camdeno/ECE-411-Team-5/breadboard prototype.jpg

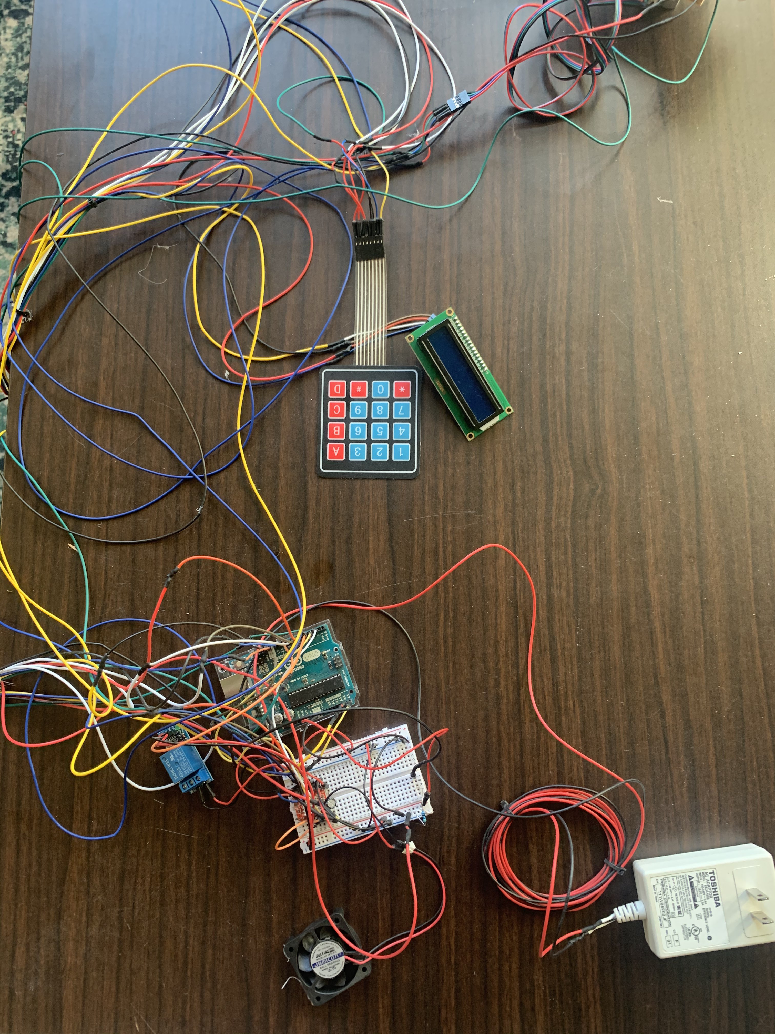
breadboard prototype.jpg
