camdeno/ECE-411-Team-5/README.md

# ECE-411-Team-5
This is our practicum project repository for ECE 411 Fall Term
