camdeno/ECE-411-Team-5/Schematics/Preliminary/readme.txt

- Add the 'Preliminary' folder under C:\...\Documents\EAGLE\projects
- Open EAGLE and you should be able to see 'Preliminary' under projects->projects

OR

- Open EAGLE and create a new project
- Import the 'Pre_sch.sch' file into your project
- Click on 'Generate / Switch board' to create a board layout
