camdeno/ECE-411-Team-5/Schematics/Final/readme.txt

This folder will contain the final schematic and board layout for the Door Lock project
