camdeno/ECE-411-Team-5/Door Lock UML.pdf

Door Lock
Team 05

Cam Osborn
Thomas Courcy
Daniel Sayenko
Abdullah Almarzouq

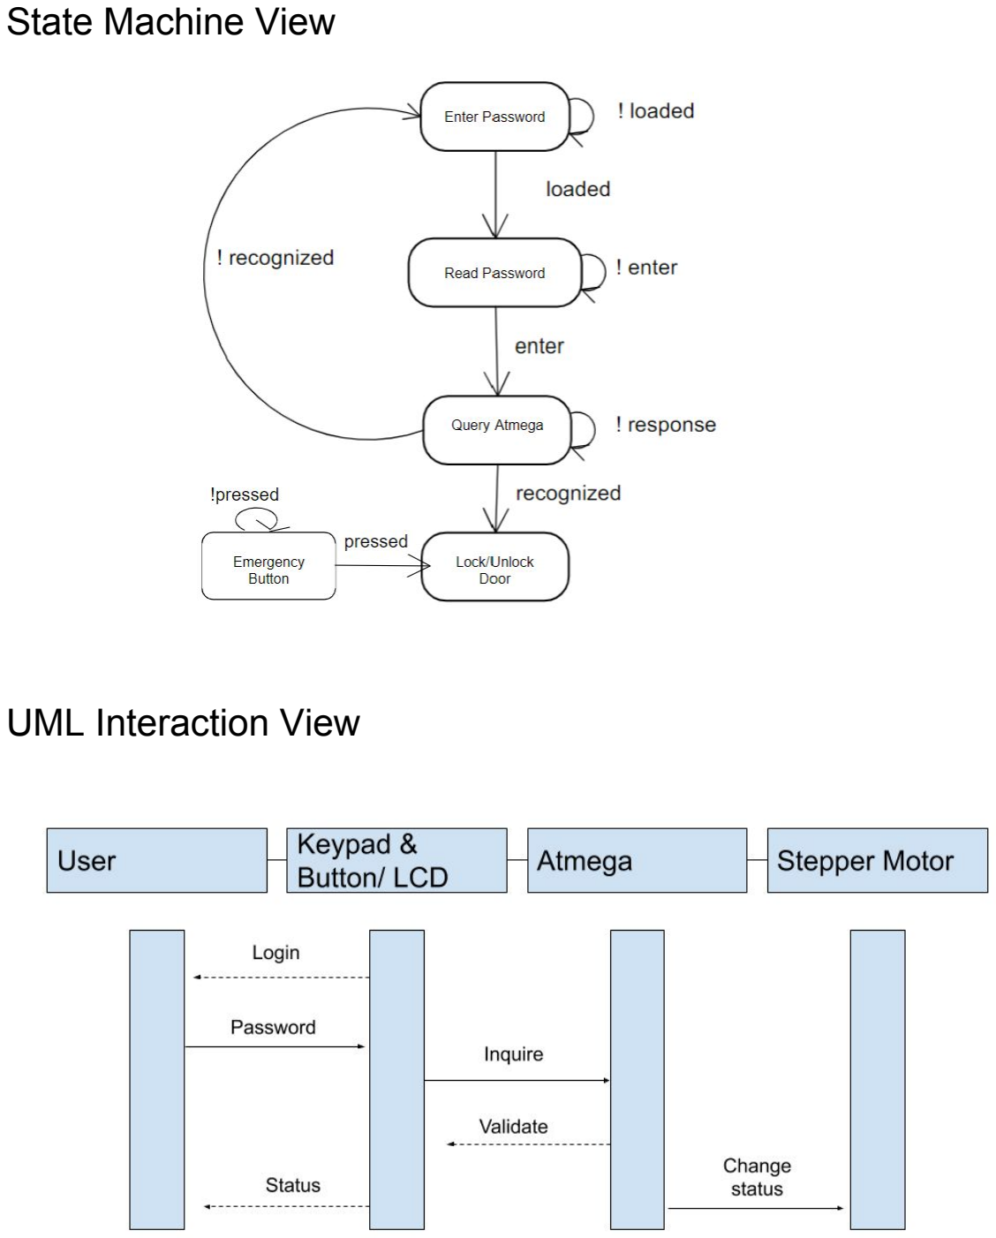
[picture p12: page 2]

State Machine View

UML Interaction View

Physical View

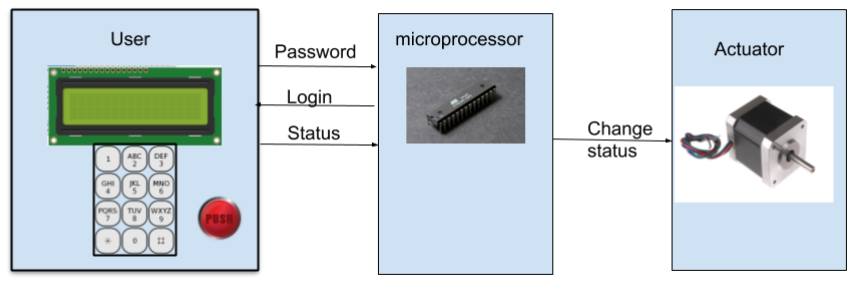
[picture p13: figure]
