camdeno/ECE-411-Team-5/3D Printing/Face_Plate v9.stl

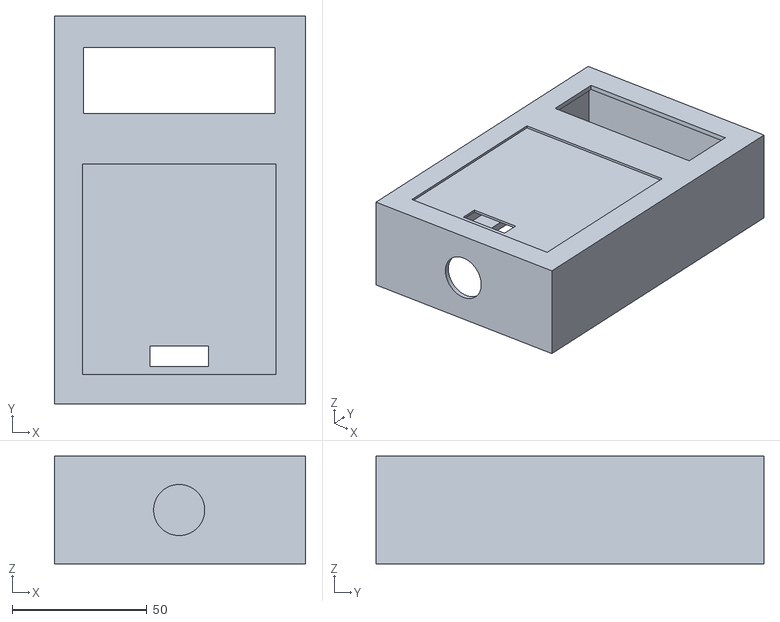
[picture p14: CAD file, 2020-12-06]
3D Printing/Face_Plate v9.stl
93.4 x 144.2 x 40.0
