camdeno/ECE-411-Team-5/3D Printing/Face_Plate v6.stl

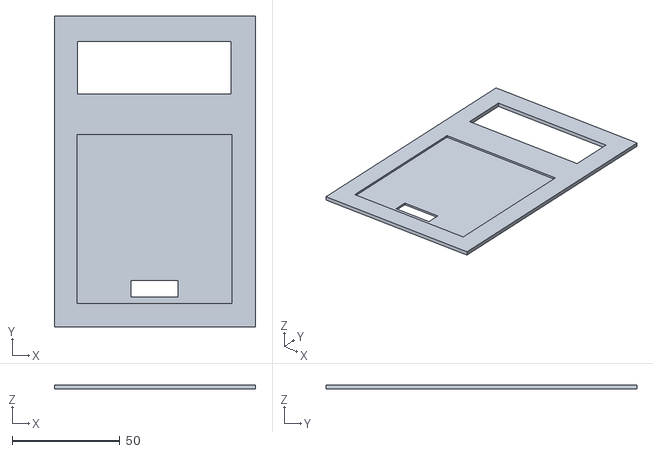
[picture p15: CAD file, 2020-11-05, an earlier design]
3D Printing/Face_Plate v6.stl
93.4 x 144.2 x 2.00
