camdeno/ECE-411-Team-5/(list of files, cad)

Other CAD files:
3D Printing/Face_Plate v8.stl
