camdeno/ECE-411-Team-5/Testing Documents/Testing Form.xlsx

Test Writer: Team 5
Test Case Name: |  |  |  |  | Test ID#:
Description: |  |  |  |  | Type:
Tester Information
 | Name of Tester: |  |  |  | Date:
Hardware Ver: |  |  |  |  | Time:
Setup:
Step | Action | Expected Result | Pass | Fail | N/A | Comments
1
2
3
4
Overall Test Result:
