camdeno/ECE-411-Team-5/Schematics/Final/schV2.2.brd

## EAGLE design Schematics/Final/schV2.2.brd (2020-11-19)

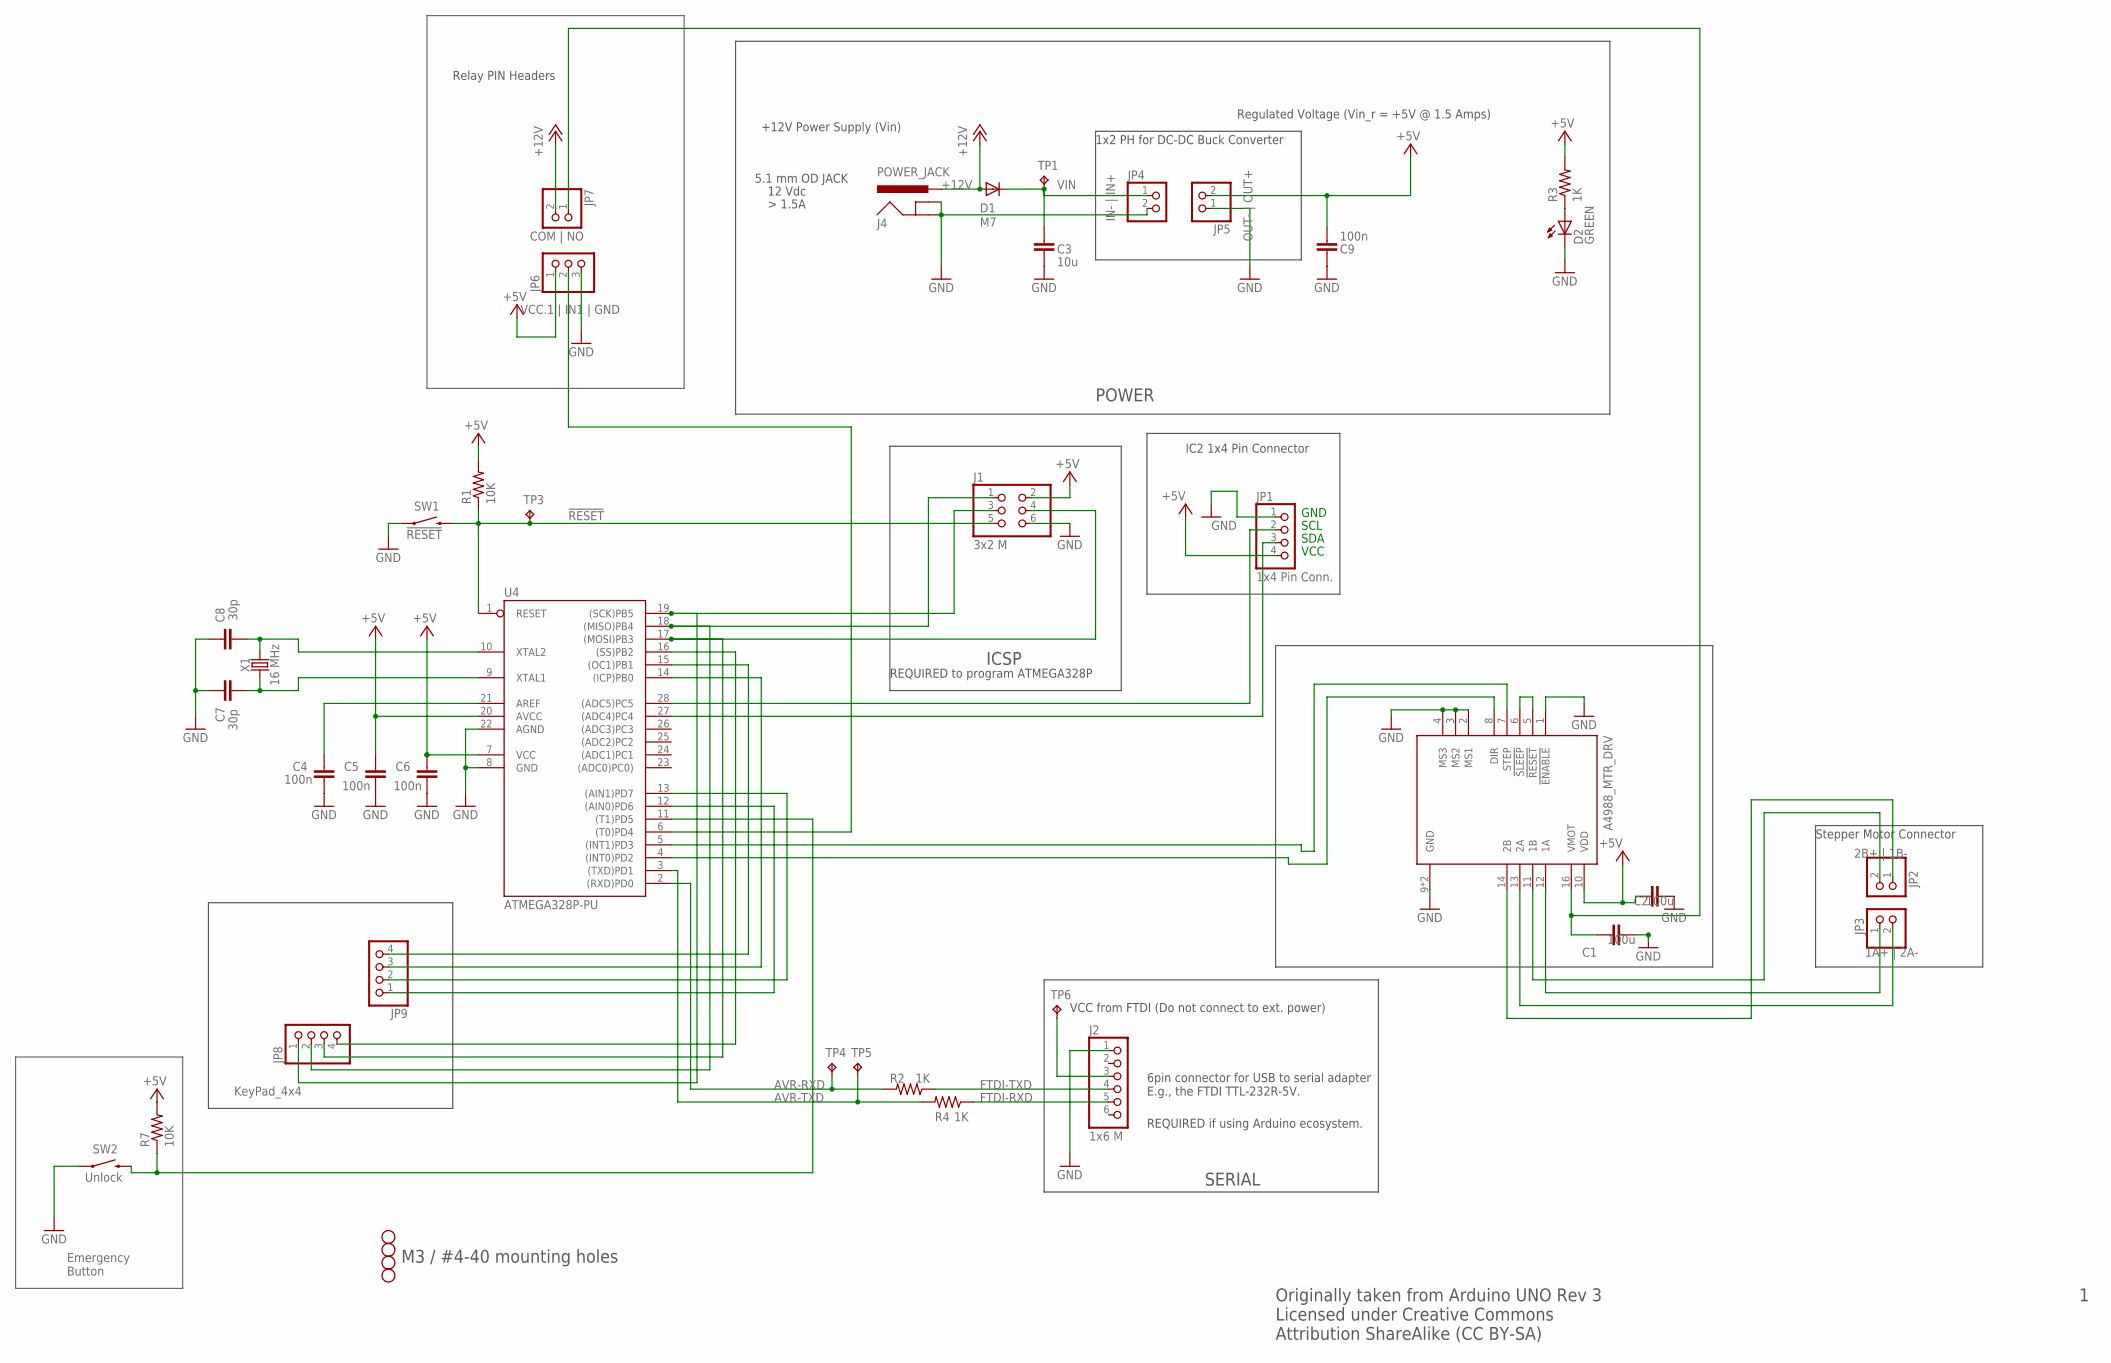
[picture p16: schematic schV2.2.sch]

Parts:
A4988_MTR_DRV: A4988_STEPPER_MOTOR_DRIVER_CARRIER; MODULE_A4988_STEPPER_MOTOR_DRIVER_CARRIER
C1, C2: 100u; C0805K; MPN CL21B104KBCNNNC
C3: 10u; C0805K; MPN CL21A106KOQNNNG
C4, C5, C6, C9: 100n; C0805K; MPN CL21B104KBCNNNC
C7: 30p; C0805K; MPN CL21C180JBANNNC
C8: 30p; C0805K; MPN CL21C300JBANNNC
D1: M7; SMB; MPN 10BQ030TR
D2: GREEN; CHIP-LED0805; MPN 150080GS75000
H1, H2, H3, H4: STAND-OFF
J1: 3x2 M; 2X03; MPN M20-9980345
J2: 1x6 M; 1X06; MPN PRPC006SAAN-RC
J4: POWER_JACK; POWER_JACK_PTH; MPN PJ-202A
JP1: 1x4 Pin Conn.; 1X04
JP2: 2B+ | 1B-; 1X02
JP3: 1A+ | 2A-; 1X02
JP4: IN- | IN+; 1X02
JP5: OUT- | OUT+; 1X02
JP6: VCC.1 | IN1 | GND; 1X03
JP7: COM | NO; 1X02
JP8, JP9: PINHD-1X4; 1X04
R1, R7: 10K; R0805; MPN RC0805FR-0710KL
R2, R3, R4: 1K; R0805; MPN RC0805FR-071KL
SW1: !RESET; TACTILE_SWITCH_SMD; MPN RS-187R05A2-DS MT RT
SW2: Unlock; TACTILE_SWITCH_SMD; MPN RS-187R05A2-DS MT RT
TP1, TP3, TP4, TP5, TP6: TPPAD1-13; P1-13
U4: ATMEGA328P-PU; DIL28-3; MPN ATMEGA328P-PU
X1: 16 MHz; HC49UP; MPN ECS-160-18-5PX-TR

Connections:
!RESET: J1.5, R1.1, SW1.3 (2), TP3.TP, U4.1 (RESET)
+5V: A4988_MTR_DRV.10 (VDD), C2.2, C5.2, C6.2, C9.2, J1.2, JP1.4, JP5.2, JP6.1, R1.2, R3.2, R7.2, U4.7 (VCC), U4.20 (AVCC)
+12V: D1.A, J4.PWR, JP7.2
AVR-RXD: R2.2, TP4.TP, U4.2 ((RXD)PD0)
AVR-TXD: R4.2, TP5.TP, U4.3 ((TXD)PD1)
FTDI-RXD: J2.5, R4.1
FTDI-TXD: J2.4, R2.1
GND: A4988_MTR_DRV.1 (!ENABLE), A4988_MTR_DRV.2 (MS1), A4988_MTR_DRV.3 (MS2), A4988_MTR_DRV.4 (MS3), A4988_MTR_DRV.9 (GND), A4988_MTR_DRV.15 (GND), C1.1, C2.1, C3.2, C4.1, C5.1, C6.1, C7.2, C8.2, C9.1, D2.C, J1.6, J2.1, J4.GND, J4.GNDBREAK, JP1.1, JP4.2, JP5.1, JP6.3, SW1.1, SW2.1, U4.8 (GND), U4.22 (AGND)
MISO: J1.1, JP8.2, U4.18 ((MISO)PB4)
MOSI: J1.4, JP8.3, U4.17 ((MOSI)PB3)
unnamed: C4.2, U4.21 (AREF)
unnamed: A4988_MTR_DRV.8 (DIR), U4.4 ((INT0)PD2)
unnamed: D2.A, R3.1
unnamed: A4988_MTR_DRV.7 (STEP), U4.5 ((INT1)PD3)
unnamed: J2.3, TP6.TP
unnamed: JP1.3, U4.27 ((ADC4)PC4)
unnamed: A4988_MTR_DRV.11 (1B), JP2.2
unnamed: A4988_MTR_DRV.12 (1A), JP3.1
unnamed: A4988_MTR_DRV.13 (2A), JP3.2
unnamed: A4988_MTR_DRV.14 (2B), JP2.1
unnamed: JP1.2, U4.28 ((ADC5)PC5)
unnamed: JP9.1, U4.12 ((AIN0)PD6)
unnamed: JP9.2, U4.13 ((AIN1)PD7)
unnamed: JP9.3, U4.14 ((ICP)PB0)
unnamed: JP9.4, U4.15 ((OC1)PB1)
unnamed: JP8.4, U4.16 ((SS)PB2)
unnamed: JP6.2, U4.6 ((T0)PD4)
unnamed: R7.1, SW2.3 (2), U4.11 ((T1)PD5)
unnamed: A4988_MTR_DRV.5 (!RESET), A4988_MTR_DRV.6 (!SLEEP)
unnamed: A4988_MTR_DRV.16 (VMOT), C1.2, JP7.1
SCK: J1.3, JP8.1, U4.19 ((SCK)PB5)
VIN: C3.1, D1.C, JP4.1, TP1.TP
XTAL1: C7.1, U4.9 (XTAL1), X1.1
XTAL2: C8.1, U4.10 (XTAL2), X1.2

Notes on the sheet:
POWER
ICSP
6pin connector for USB to serial adapter E.g., the FTDI TTL-232R-5V.
REQUIRED if using Arduino ecosystem.
M3 / #4-40 mounting holes
SERIAL
REQUIRED to program ATMEGA328P
VCC from FTDI (Do not connect to ext. power)
Originally taken from Arduino UNO Rev 3 Licensed under Creative Commons Attribution ShareAlike (CC BY-SA)
+12V Power Supply (Vin)
Regulated Voltage (Vin_r = +5V @ 1.5 Amps)
KeyPad_4x4
Emergency Button
GND
SCL
SDA
VCC
Stepper Motor Connector
IC2 1x4 Pin Connector
12 Vdc
5.1 mm OD JACK
1x2 PH for DC-DC Buck Converter
Relay PIN Headers

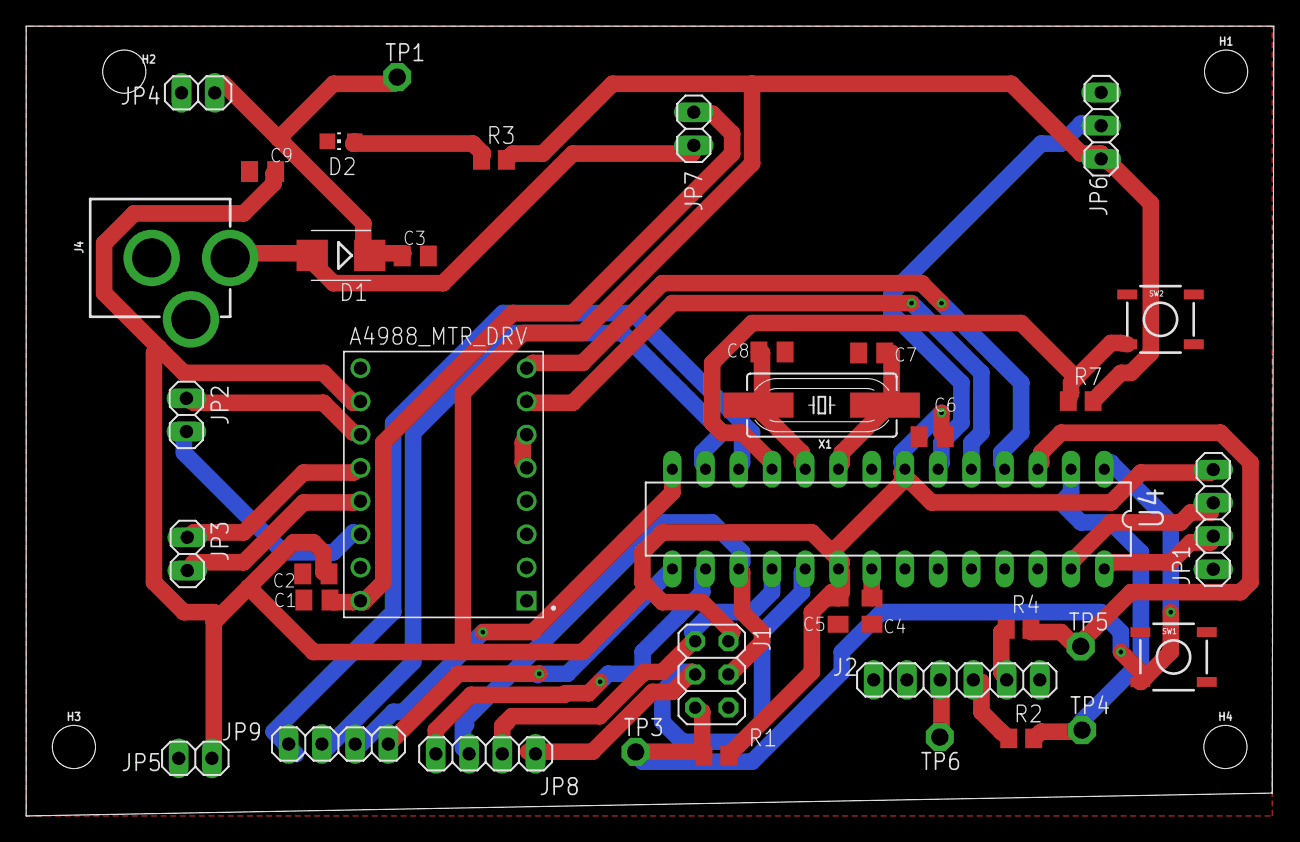
[picture p17: board schV2.2.brd from above]

Board: 2 copper layers, 95.4 x 60.4 mm, 42 parts (0 on the bottom side), 34 nets.
