camdeno/ECE-411-Team-5/Schematics/Preliminary/Pre_sch.brd

## EAGLE design Schematics/Preliminary/Pre_sch.brd (2020-11-09)

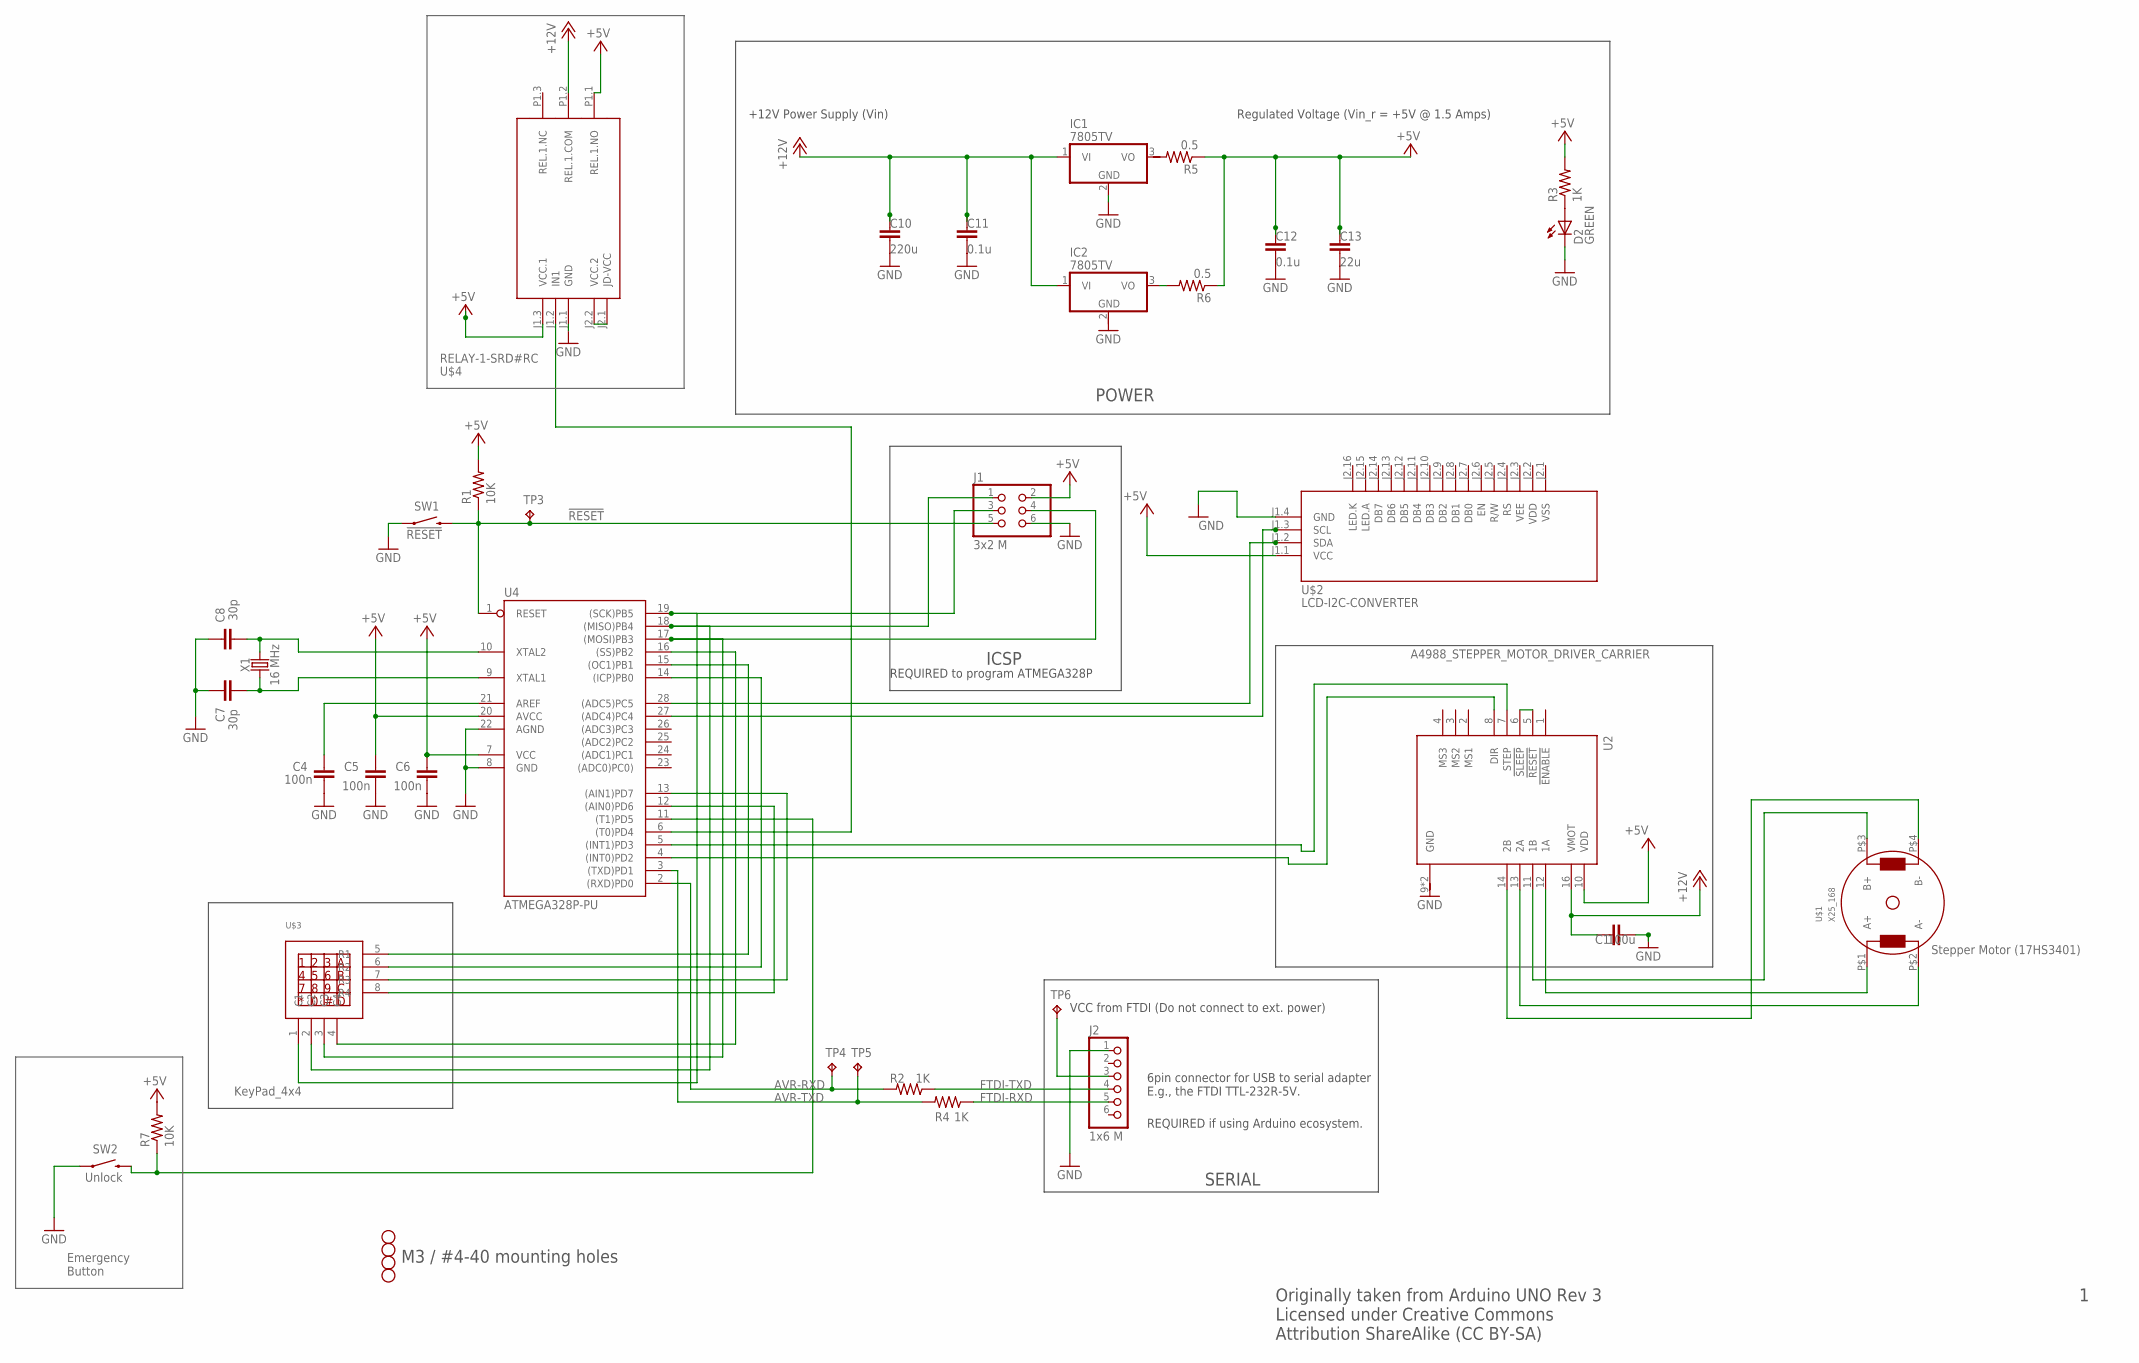
[picture p18: schematic Pre_sch.sch]

Parts:
C1: 100u; C0805K; MPN CL21B104KBCNNNC
C4, C5, C6: 100n; C0805K; MPN CL21B104KBCNNNC
C7: 30p; C0805K; MPN CL21C180JBANNNC
C8: 30p; C0805K; MPN CL21C300JBANNNC
C10: 220u; C0805K; MPN CL21B104KBCNNNC
C11, C12: 0.1u; C0805K; MPN CL21B104KBCNNNC
C13: 22u; C0805K; MPN CL21B104KBCNNNC
D2: GREEN; CHIP-LED0805; MPN 150080GS75000
H1, H2, H3, H4: STAND-OFF
IC1, IC2: 7805TV; TO220V
J1: 3x2 M; 2X03; MPN M20-9980345
J2: 1x6 M; 1X06; MPN PRPC006SAAN-RC
R1, R7: 10K; R0805; MPN RC0805FR-0710KL
R2, R3, R4: 1K; R0805; MPN RC0805FR-071KL
R5, R6: 0.5; R0805; MPN RC0805FR-071KL
SW1: !RESET; TACTILE_SWITCH_SMD; MPN RS-187R05A2-DS MT RT
SW2: Unlock; TACTILE_SWITCH_SMD; MPN RS-187R05A2-DS MT RT
TP3, TP4, TP5, TP6: TPPAD1-13; P1-13
U2: A4988_STEPPER_MOTOR_DRIVER_CARRIER; MODULE_A4988_STEPPER_MOTOR_DRIVER_CARRIER
U4: ATMEGA328P-PU; DIL28-3; MPN ATMEGA328P-PU
U$1: X25_168
U$2: LCD-I2C-CONVERTER
U$3: KEYPAD4X4
U$4: RELAY-1-SRD#RC
X1: 16 MHz; HC49UP; MPN ECS-160-18-5PX-TR

Connections:
!RESET: J1.5, R1.1, SW1.3 (2), TP3.TP, U4.1 (RESET)
+5V: C5.2, C6.2, C12.2, C13.2, J1.2, R1.2, R3.2, R5.1, R6.1, R7.2, U2.10 (VDD), U4.7 (VCC), U4.20 (AVCC), U$2.J1.1 (VCC), U$4.J1.3 (VCC.1), U$4.P1.1 (REL.1.NO)
+12V: C1.2, C10.2, C11.2, IC1.1 (VI), IC2.1 (VI), U2.16 (VMOT), U$4.P1.2 (REL.1.COM)
AVR-RXD: R2.2, TP4.TP, U4.2 ((RXD)PD0)
AVR-TXD: R4.2, TP5.TP, U4.3 ((TXD)PD1)
FTDI-RXD: J2.5, R4.1
FTDI-TXD: J2.4, R2.1
GND: C1.1, C4.1, C5.1, C6.1, C7.2, C8.2, C10.1, C11.1, C12.1, C13.1, D2.C, IC1.2 (GND), J1.6, J2.1, SW1.1, SW2.1, U2.9 (GND), U2.15 (GND), U4.8 (GND), U4.22 (AGND), U$2.J1.4 (GND), U$4.J1.1 (GND)
MISO: J1.1, U4.18 ((MISO)PB4), U$3.2 (C2)
MOSI: J1.4, U4.17 ((MOSI)PB3), U$3.3 (C3)
unnamed: C4.2, U4.21 (AREF)
unnamed: U2.8 (DIR), U4.4 ((INT0)PD2)
unnamed: D2.A, R3.1
unnamed: U2.7 (STEP), U4.5 ((INT1)PD3)
unnamed: J2.3, TP6.TP
unnamed: U4.27 ((ADC4)PC4), U$2.J1.3 (SCL)
unnamed: U2.5 (!RESET), U2.6 (!SLEEP)
unnamed: U2.11 (1B), U$1.P$3 (B+)
unnamed: U2.12 (1A), U$1.P$1 (A+)
unnamed: U2.13 (2A), U$1.P$2 (A-)
unnamed: U2.14 (2B), U$1.P$4 (B-)
unnamed: U4.28 ((ADC5)PC5), U$2.J1.2 (SDA)
unnamed: IC2.3 (VO), R6.2
unnamed: U4.12 ((AIN0)PD6), U$3.8 (R4)
unnamed: U4.13 ((AIN1)PD7), U$3.7 (R3)
unnamed: U4.14 ((ICP)PB0), U$3.6 (R2)
unnamed: U4.15 ((OC1)PB1), U$3.5 (R1)
unnamed: U4.16 ((SS)PB2), U$3.4 (C4)
unnamed: U$4.J2.1 (JD-VCC), U$4.J2.2 (VCC.2)
unnamed: U4.6 ((T0)PD4), U$4.J1.2 (IN1)
unnamed: R7.1, SW2.3 (2), U4.11 ((T1)PD5)
SCK: J1.3, U4.19 ((SCK)PB5), U$3.1 (C1)
XTAL1: C7.1, U4.9 (XTAL1), X1.1
XTAL2: C8.1, U4.10 (XTAL2), X1.2

Notes on the sheet:
POWER
ICSP
6pin connector for USB to serial adapter E.g., the FTDI TTL-232R-5V.
REQUIRED if using Arduino ecosystem.
M3 / #4-40 mounting holes
SERIAL
REQUIRED to program ATMEGA328P
VCC from FTDI (Do not connect to ext. power)
Originally taken from Arduino UNO Rev 3 Licensed under Creative Commons Attribution ShareAlike (CC BY-SA)
Stepper Motor (17HS3401)
+12V Power Supply (Vin)
Regulated Voltage (Vin_r = +5V @ 1.5 Amps)
KeyPad_4x4
Emergency Button

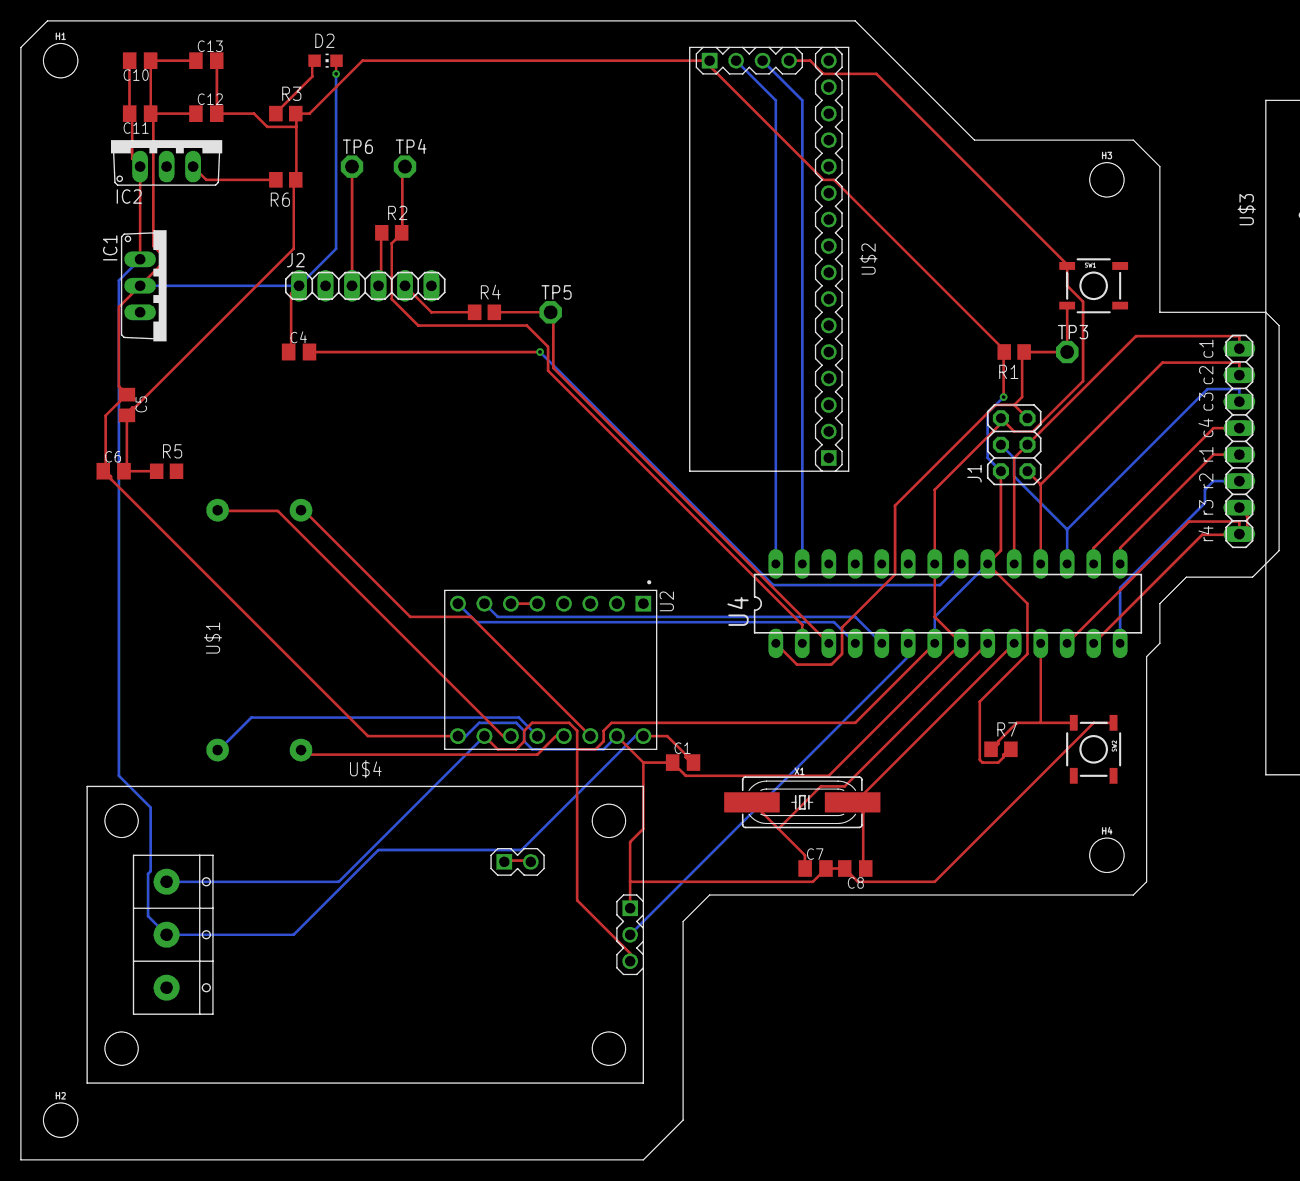
[picture p19: board Pre_sch.brd from above]

Board: 2 copper layers, 120.7 x 109.2 mm, 39 parts (0 on the bottom side), 34 nets.
