camdeno/ECE-411-Team-5/(commit log)

2020-11-02 Preliminary schematic initial commit
    [Preliminary Schematic.sch]
2020-11-02 Picture of Door Lock prototype
2020-11-08 Created directory for schematics and board layout | Preliminary schematic is done | board layout needs organization
    [Pre_sch.brd, Pre_sch.sch]
2020-11-08 Created folder 'Final' under 'Schematics'
2020-11-08 Better board template; still needs rearranging
    [Pre_sch.brd]
2020-11-09 Preliminary Board Layout is done
    [Pre_sch.brd, Pre_sch.sch]
2020-11-11 Initial BOM (.pdf & .xlsx)
    [BOM#1.xlsx]
2020-11-11 Minor Fix: a cell's boarder was missing
    [BOM#1.xlsx]
2020-11-16 Add files via upload
    The Stepper motor and IC2 was replaced with pin headers. The relay REL.1.NO is now connected to the stepper motor driver VMOT and bypass caps were added. The power supply still needs to be fixed.
    [Pre_schV2.sch]
2020-11-16 Add files via upload
    Pin headers were added for the stepper motor and IC2. The relay REL1.NO was connected to the stepper motor driver & by pass caps were added.
    [Pre_schV2.sch]
2020-11-16 Fixed ERC Errors and Warnings
    [Pre_schV2.sch]
2020-11-16 moved Pre_schV2.sch to Schematics/rough
    [Pre_schV2.sch]
2020-11-17 Add files via upload
    Relay & Buck converter pin headers were added
    [Pre_schV2.1.sch]
2020-11-17 Add files via upload
    Here is a smaller PCB design.
    [Pre_schV2.1.brd]
2020-11-18 Final Schematic and Board commited to Schematic/Final folder
    [schV2.2.brd, schV2.2.sch]
2020-12-01 Completed Code -- still missing ability to change the keypad code
    [securitySystemCode.ino]
2020-12-02 Uploaded Testing form for practicum HW
    [Testing Form.xlsx]
2020-12-06 Added hole for wires at the bottom of the face
    [Face_Plate v9.stl]
2020-12-08 Fixed the project schedule according to feedback
    [securitySystemCode.ino]
