camdeno/ECE-411-Team-5/(notices)

Notices in the files:
parts and their libraries:
SparkFun-Hardware: Licensing: Creative Commons ShareAlike 4.0 International - https://creativecommons.org/licenses/by-sa/4.0
SparkFun-Electromechanical: Licensing: CC v3.0 Share-Alike You are welcome to use this library for commercial purposes.
